MiataMike/FE04-Dash/Teensy Code/Dash Plans.jpg

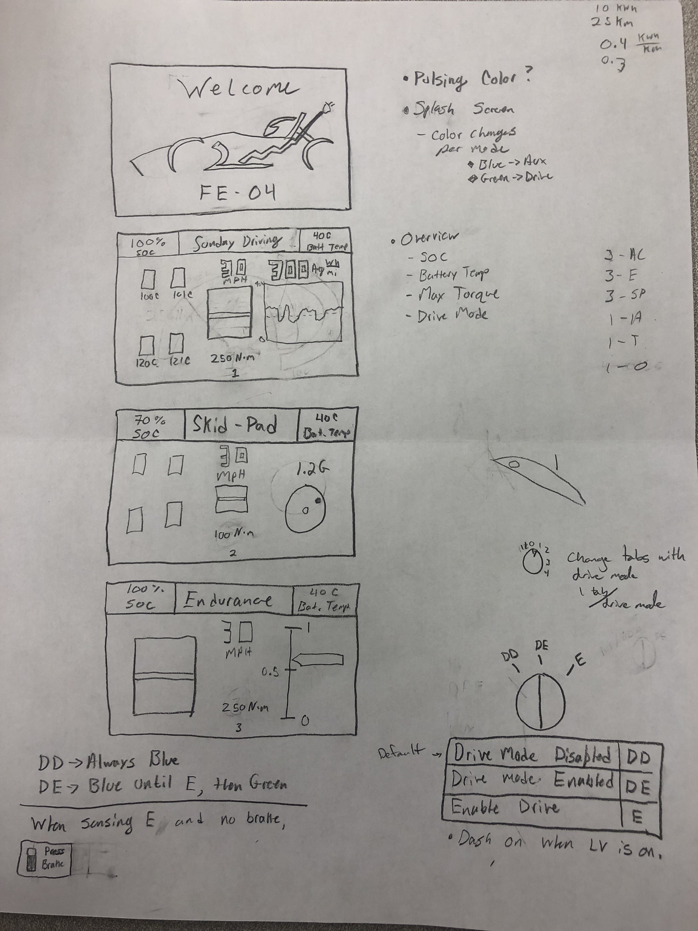
Teensy Code/Dash Plans.jpg
