MiataMike/FE04-Dash/Teensy Code/rnd.bmp

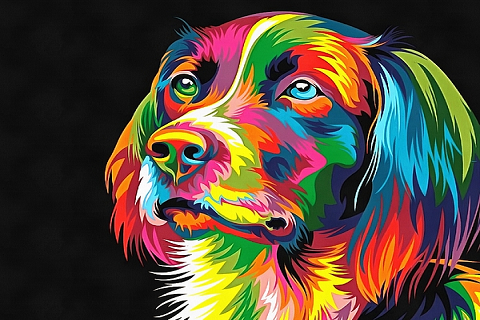
Teensy Code/rnd.bmp
