MiataMike/FE04-Dash/Teensy Code/Teensy code compliation.pptx

## Teensy code compliation

## Installing teensyduino on computer

https://www.pjrc.com/teensy/teensyduino.html

## Installing libraries

Install all of these from sketch->include library-> manage libraries

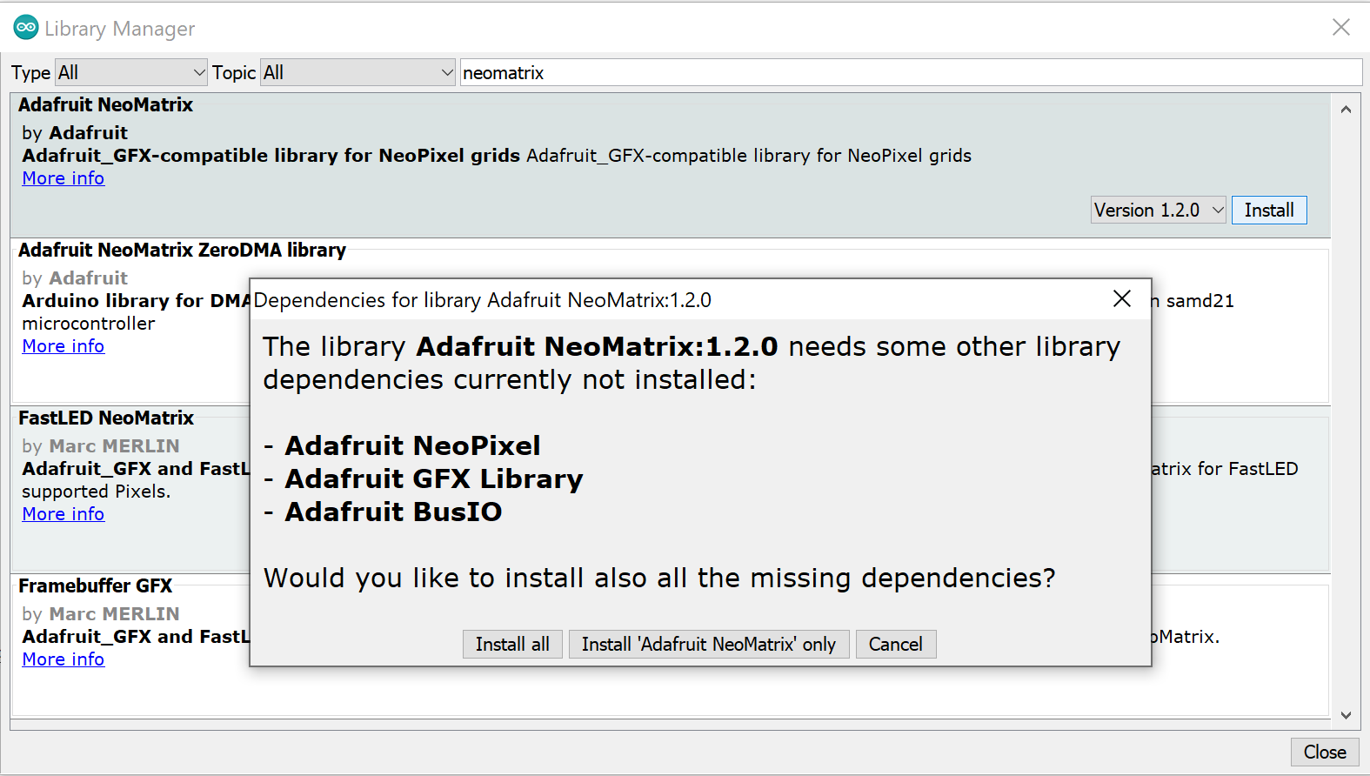
[picture p3: figure]

## Add t3 libraries

These .zip files are included in the root directory
FlexCAN_t3.zip
HX8357_t3.zip

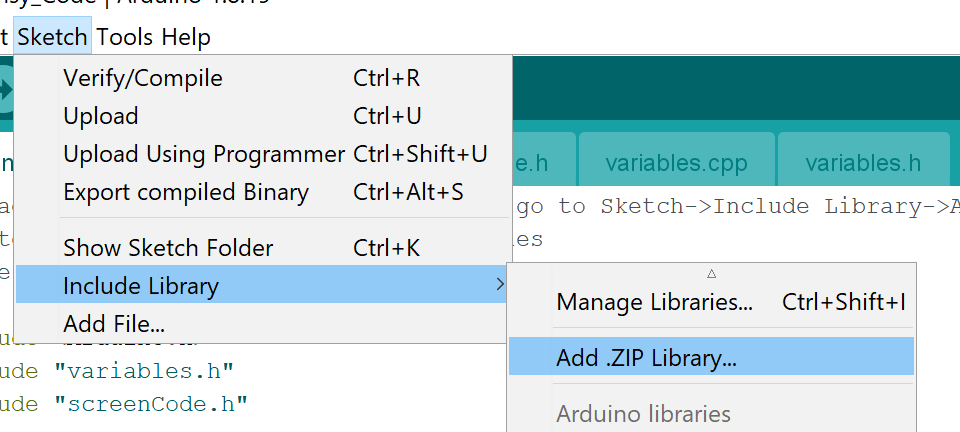
[picture p4: figure]
