MiataMike/FE04-Dash/Center Dash/Dash Sticker.pdf

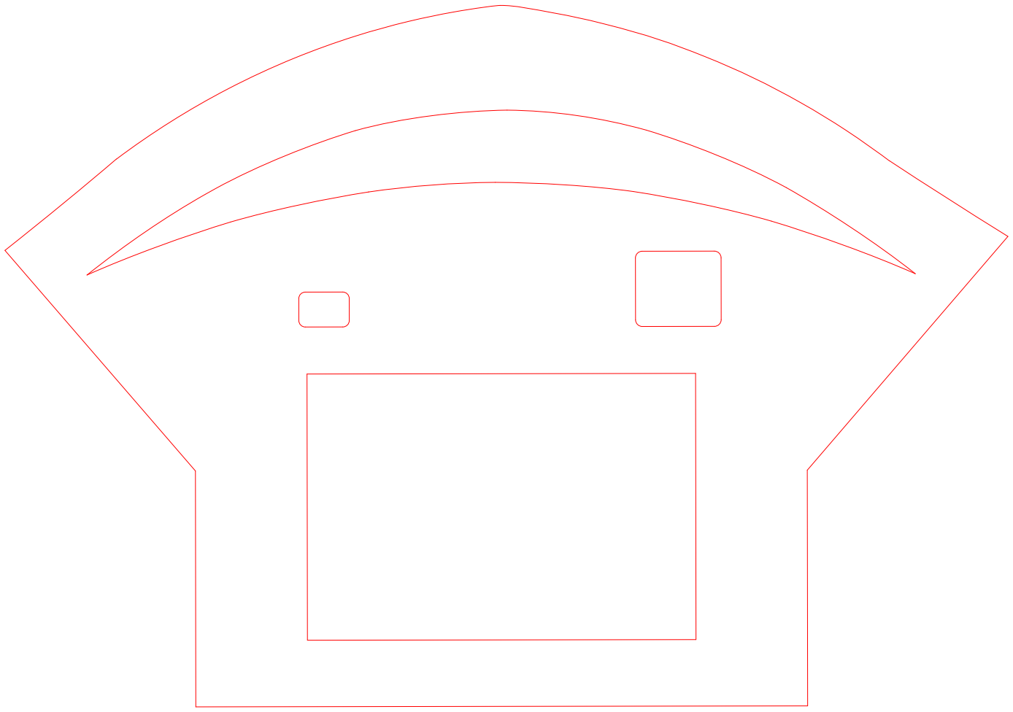
[picture p5: figure]
