MiataMike/FE04-Dash/Teensy Code/mroom.bmp

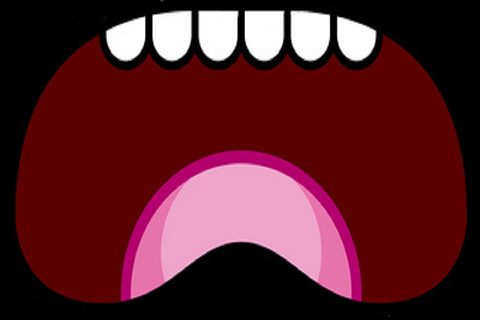
Teensy Code/mroom.bmp
