MiataMike/FE04-Dash/Steering Wheel/3D Printed Enclosure and Parts/wheel assembly v2.SLDASM

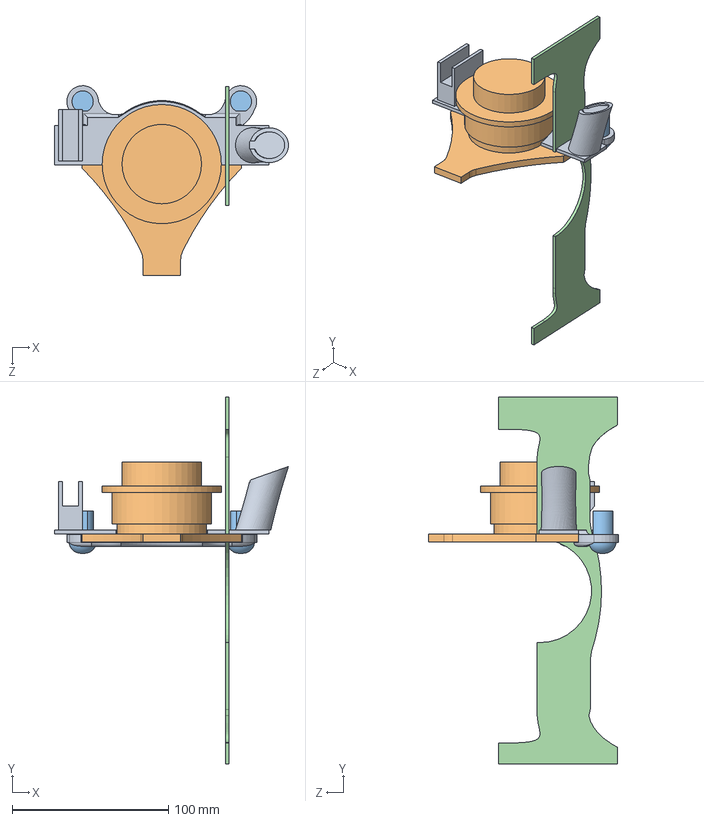
[picture p7: CAD file, 2018-05-23]
Steering Wheel/3D Printed Enclosure and Parts/wheel assembly v2.SLDASM
149.6 x 234.6 x 121.2 mm
Paddle Enclosure V3
steering_wheel
button x 2
Paddles
