MiataMike/FE04-Dash/Left Ear/Left Ear Master v2.SLDPRT

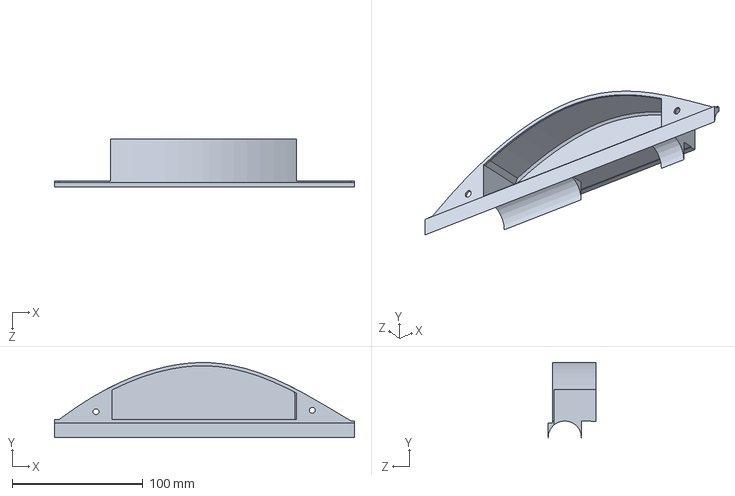
[picture p8: CAD file, 2018-03-25]
Left Ear/Left Ear Master v2.SLDPRT
229.4 x 57.4 x 36.4 mm
