MiataMike/FE04-Dash/Right Ear/Right Ear (BEST).SLDPRT

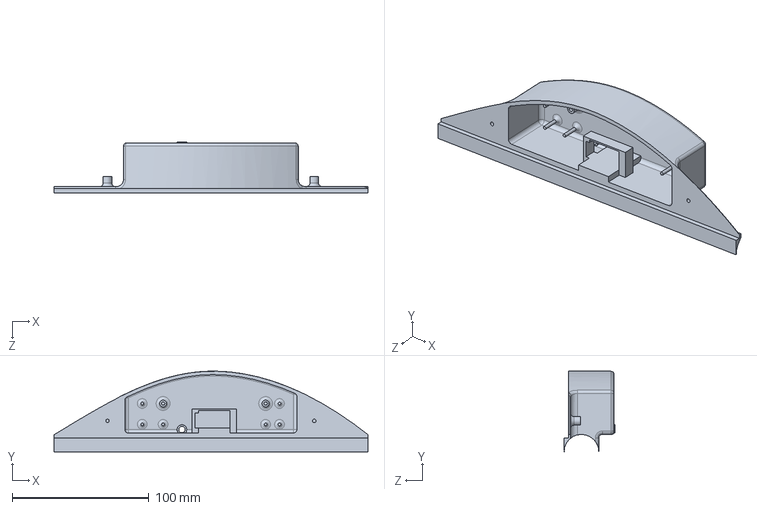
[picture p9: CAD file, 2018-03-25]
Right Ear/Right Ear (BEST).SLDPRT
229.6 x 58.9 x 37.2 mm
