MiataMike/FE04-Dash/Steering Wheel/3D Printed Enclosure and Parts/Right Ear Needle Holder.SLDPRT

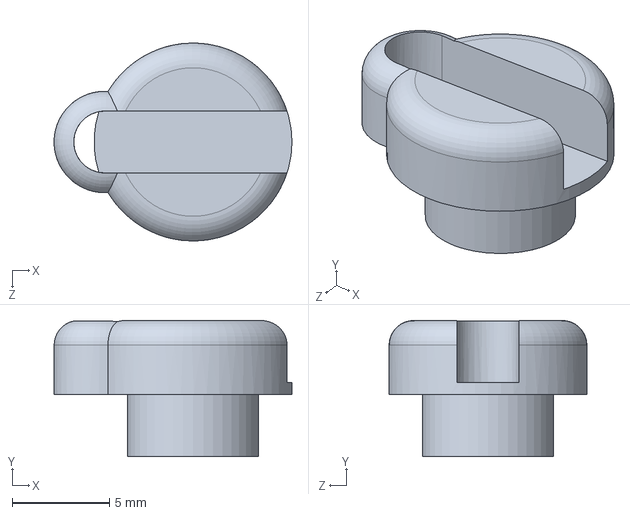
[picture p10: CAD file, 2018-05-23]
Steering Wheel/3D Printed Enclosure and Parts/Right Ear Needle Holder.SLDPRT
12.2 x 6.98 x 10.2 mm
