MiataMike/FE04-Dash/Right Ear/Servo Needle.SLDPRT

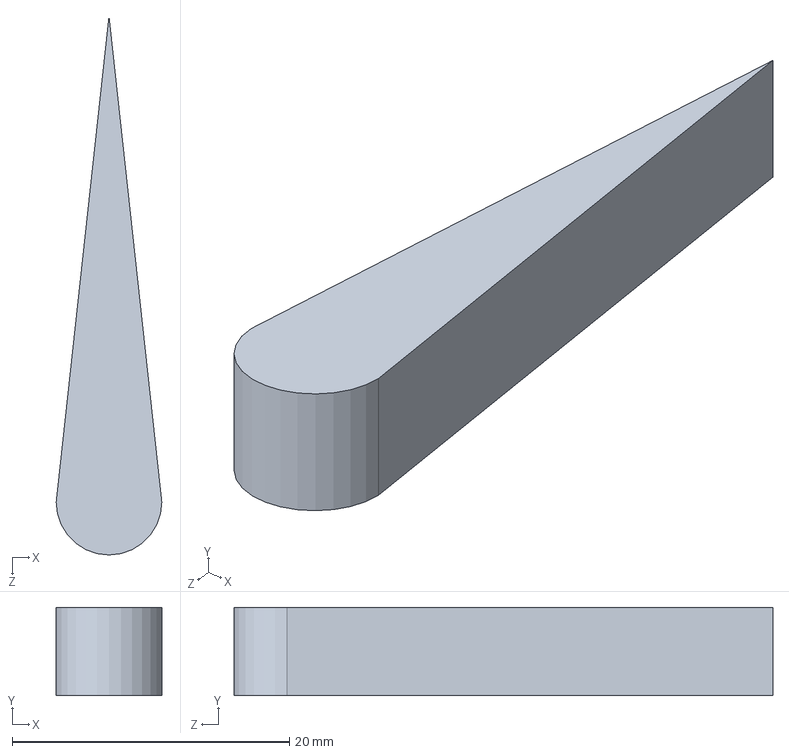
[picture p11: CAD file, 2018-03-24]
Right Ear/Servo Needle.SLDPRT
7.62 x 6.35 x 38.9 mm
