MiataMike/FE04-Dash/Steering Wheel/3D Printed Enclosure and Parts/Paddles_SM.DXF

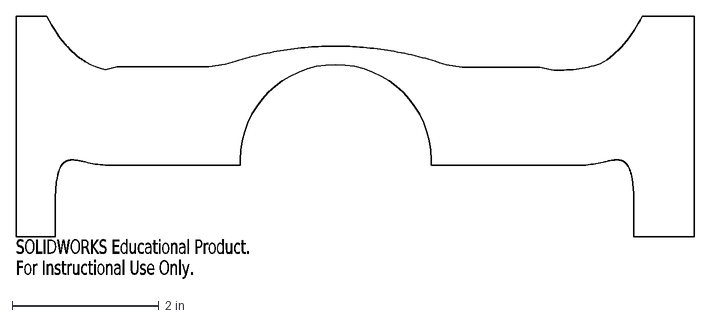
[picture p12: CAD file, 2018-05-23]
Steering Wheel/3D Printed Enclosure and Parts/Paddles_SM.DXF
SOLIDWORKS Educational Product.
For Instructional Use Only.
