MiataMike/FE04-Dash/Steering Wheel/3D Printed Enclosure and Parts/Paddles.SLDPRT

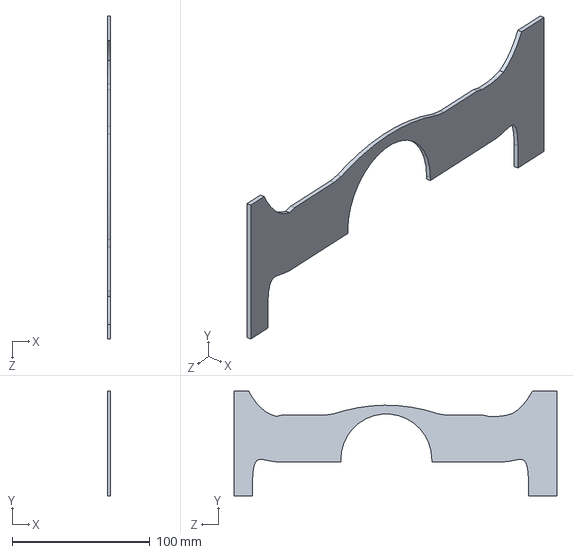
[picture p13: CAD file, 2018-05-23]
Steering Wheel/3D Printed Enclosure and Parts/Paddles.SLDPRT
2.38 x 76.2 x 234.6 mm
