MiataMike/FE04-Dash/Steering Wheel/3D Printed Enclosure and Parts/Needle.SLDPRT

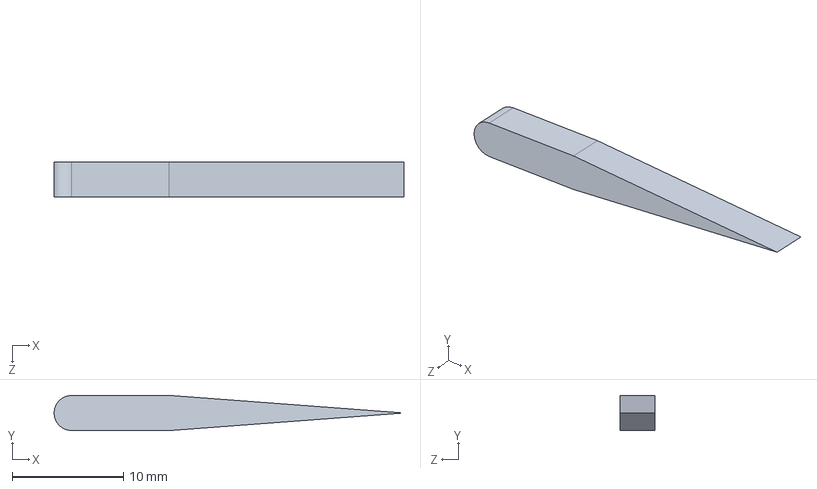
[picture p14: CAD file, 2018-05-23]
Steering Wheel/3D Printed Enclosure and Parts/Needle.SLDPRT
31.5 x 3.17 x 3.17 mm
