MiataMike/FE04-Dash/Steering Wheel/3D Printed Enclosure and Parts/Paddle Enclosure V4.SLDPRT

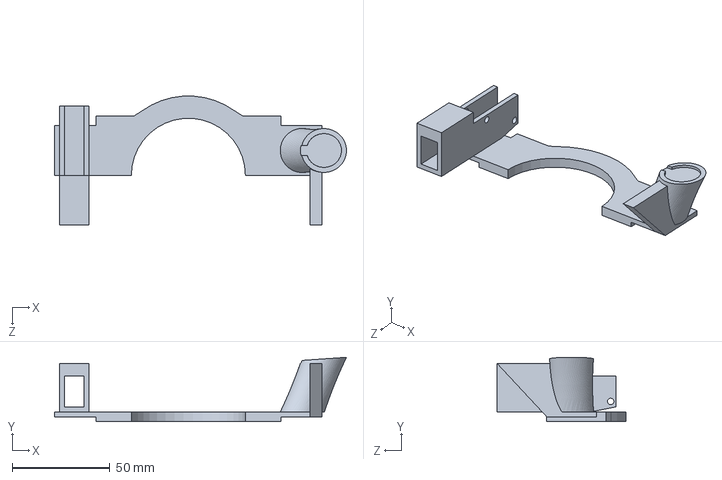
[picture p15: CAD file, 2018-05-23]
Steering Wheel/3D Printed Enclosure and Parts/Paddle Enclosure V4.SLDPRT
149.6 x 33.0 x 65.9 mm
