MiataMike/FE04-Dash/Steering Wheel/3D Printed Enclosure and Parts/Knob.SLDPRT

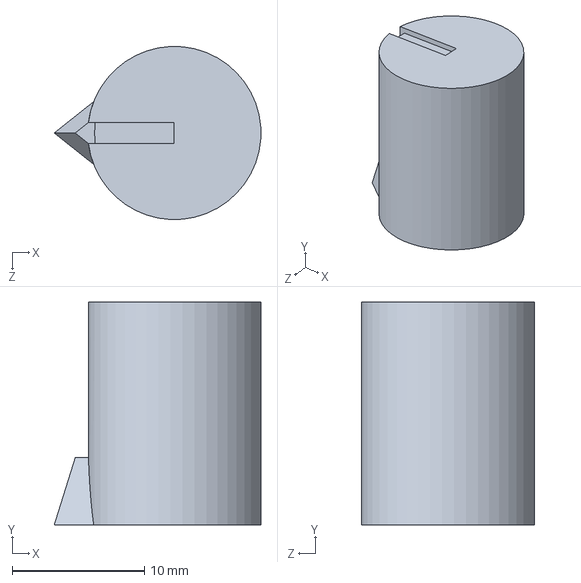
[picture p16: CAD file, 2018-05-23]
Steering Wheel/3D Printed Enclosure and Parts/Knob.SLDPRT
15.6 x 16.8 x 13.1 mm
