MiataMike/FE04-Dash/Steering Wheel/3D Printed Enclosure and Parts/Paddle Enclosure.SLDPRT

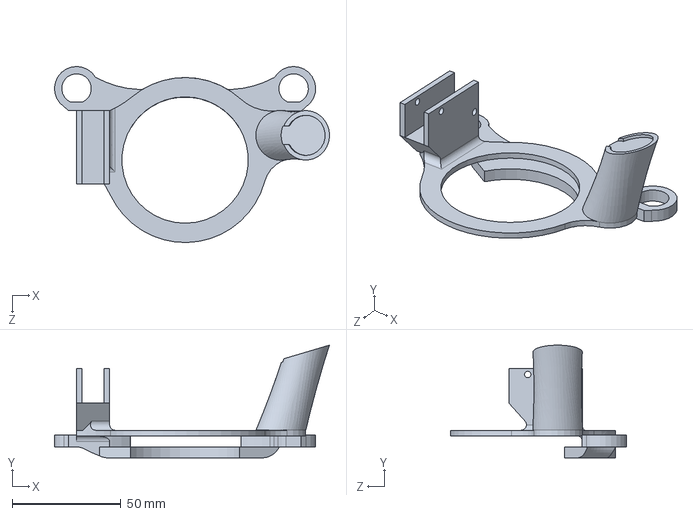
[picture p17: CAD file, 2018-05-23]
Steering Wheel/3D Printed Enclosure and Parts/Paddle Enclosure.SLDPRT
126.6 x 51.9 x 81.0 mm
