MiataMike/FE04-Dash/Steering Wheel/3D Printed Enclosure and Parts/steering_wheel.SLDPRT

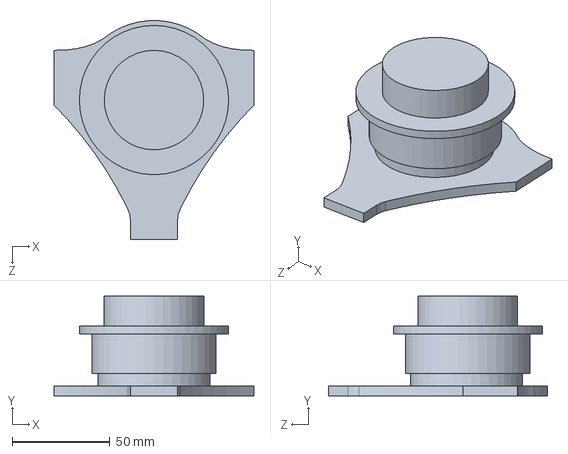
[picture p18: CAD file, 2018-05-23]
Steering Wheel/3D Printed Enclosure and Parts/steering_wheel.SLDPRT
102.1 x 51.1 x 111.7 mm
