MiataMike/FE04-Dash/Steering Wheel/3D Printed Enclosure and Parts/Switch.SLDPRT

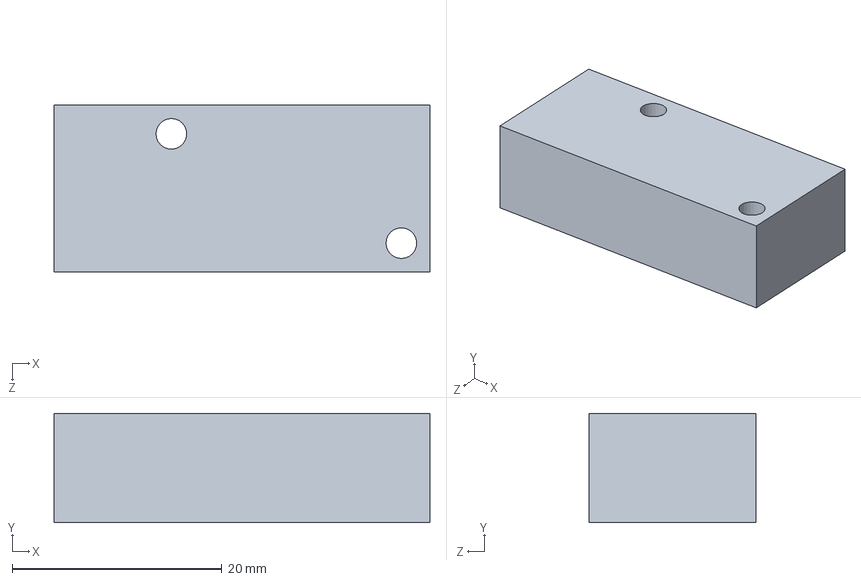
[picture p19: CAD file, 2018-04-06]
Steering Wheel/3D Printed Enclosure and Parts/Switch.SLDPRT
35.8 x 10.4 x 15.9 mm
