MiataMike/FE04-Dash/Steering Wheel/3D Printed Enclosure and Parts/button.SLDPRT

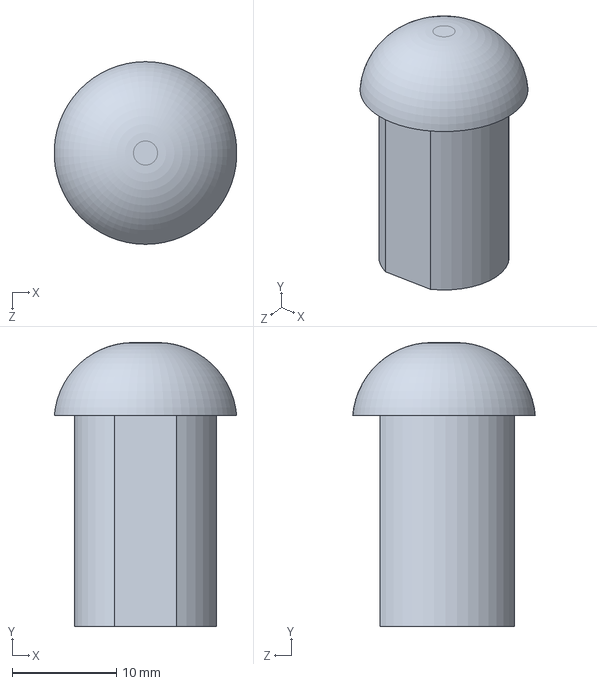
[picture p20: CAD file, 2018-04-06]
Steering Wheel/3D Printed Enclosure and Parts/button.SLDPRT
17.5 x 27.2 x 17.5 mm
