MiataMike/FE04-Dash/Steering Wheel/3D Printed Enclosure and Parts/wheel assembly.SLDASM

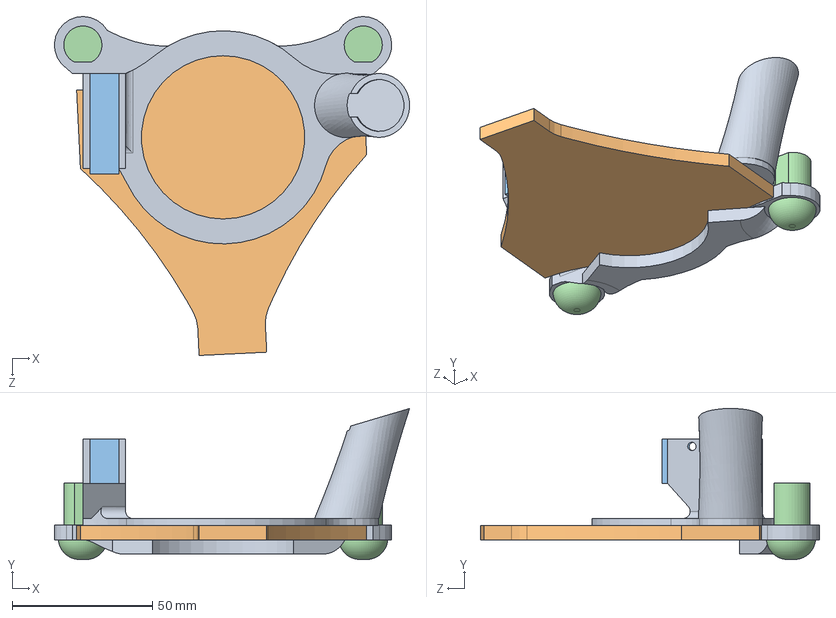
[picture p21: CAD file, 2018-04-06, an earlier design]
Steering Wheel/3D Printed Enclosure and Parts/wheel assembly.SLDASM
126.6 x 53.8 x 120.8 mm
Paddle Enclosure
steering_wheel
Switch
button x 2
