MiataMike/FE04-Dash/Steering Wheel/3D Printed Enclosure and Parts/Paddle Enclosure V3.SLDPRT

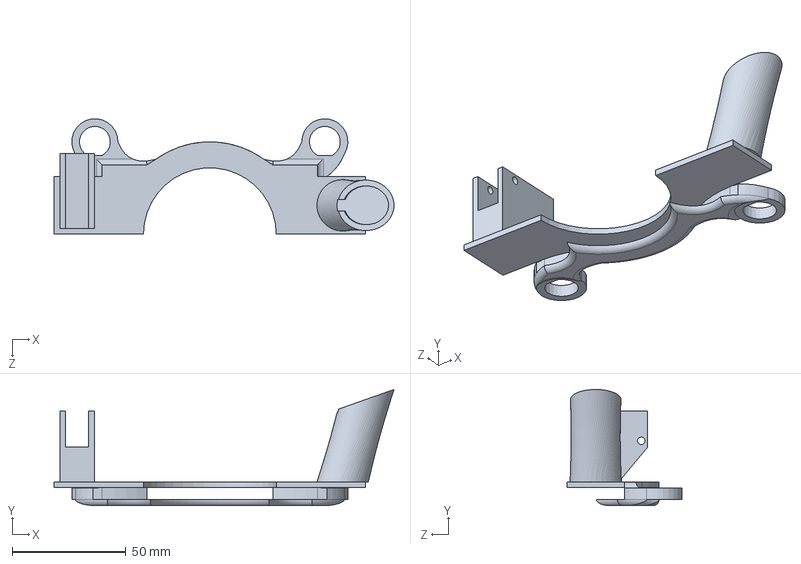
[picture p22: CAD file, 2018-05-23, an earlier design]
Steering Wheel/3D Printed Enclosure and Parts/Paddle Enclosure V3.SLDPRT
149.6 x 51.1 x 50.8 mm
