MiataMike/FE04-Dash/(list of files, cad)

Other CAD files:
Steering Wheel/3D Printed Enclosure and Parts/Right Ear Needle.SLDPRT
Steering Wheel/3D Printed Enclosure and Parts/Paddle Enclosure V2.SLDPRT
Left Ear/Left Ear Master v2.STL
Right Ear/Right Ear (BEST).STL
Right Ear/Servo Needle.DXF
Steering Wheel/3D Printed Enclosure and Parts/Knob.STL
Steering Wheel/3D Printed Enclosure and Parts/Paddle Enclosure V3.STL
Steering Wheel/3D Printed Enclosure and Parts/Paddle Enclosure V4.STL
Steering Wheel/3D Printed Enclosure and Parts/Right Ear Needle Holder.STL
