MiataMike/FE04-Dash/Center Dash/Center Dash.brd

## EAGLE design Center Dash/Center Dash.brd (2021-10-16)

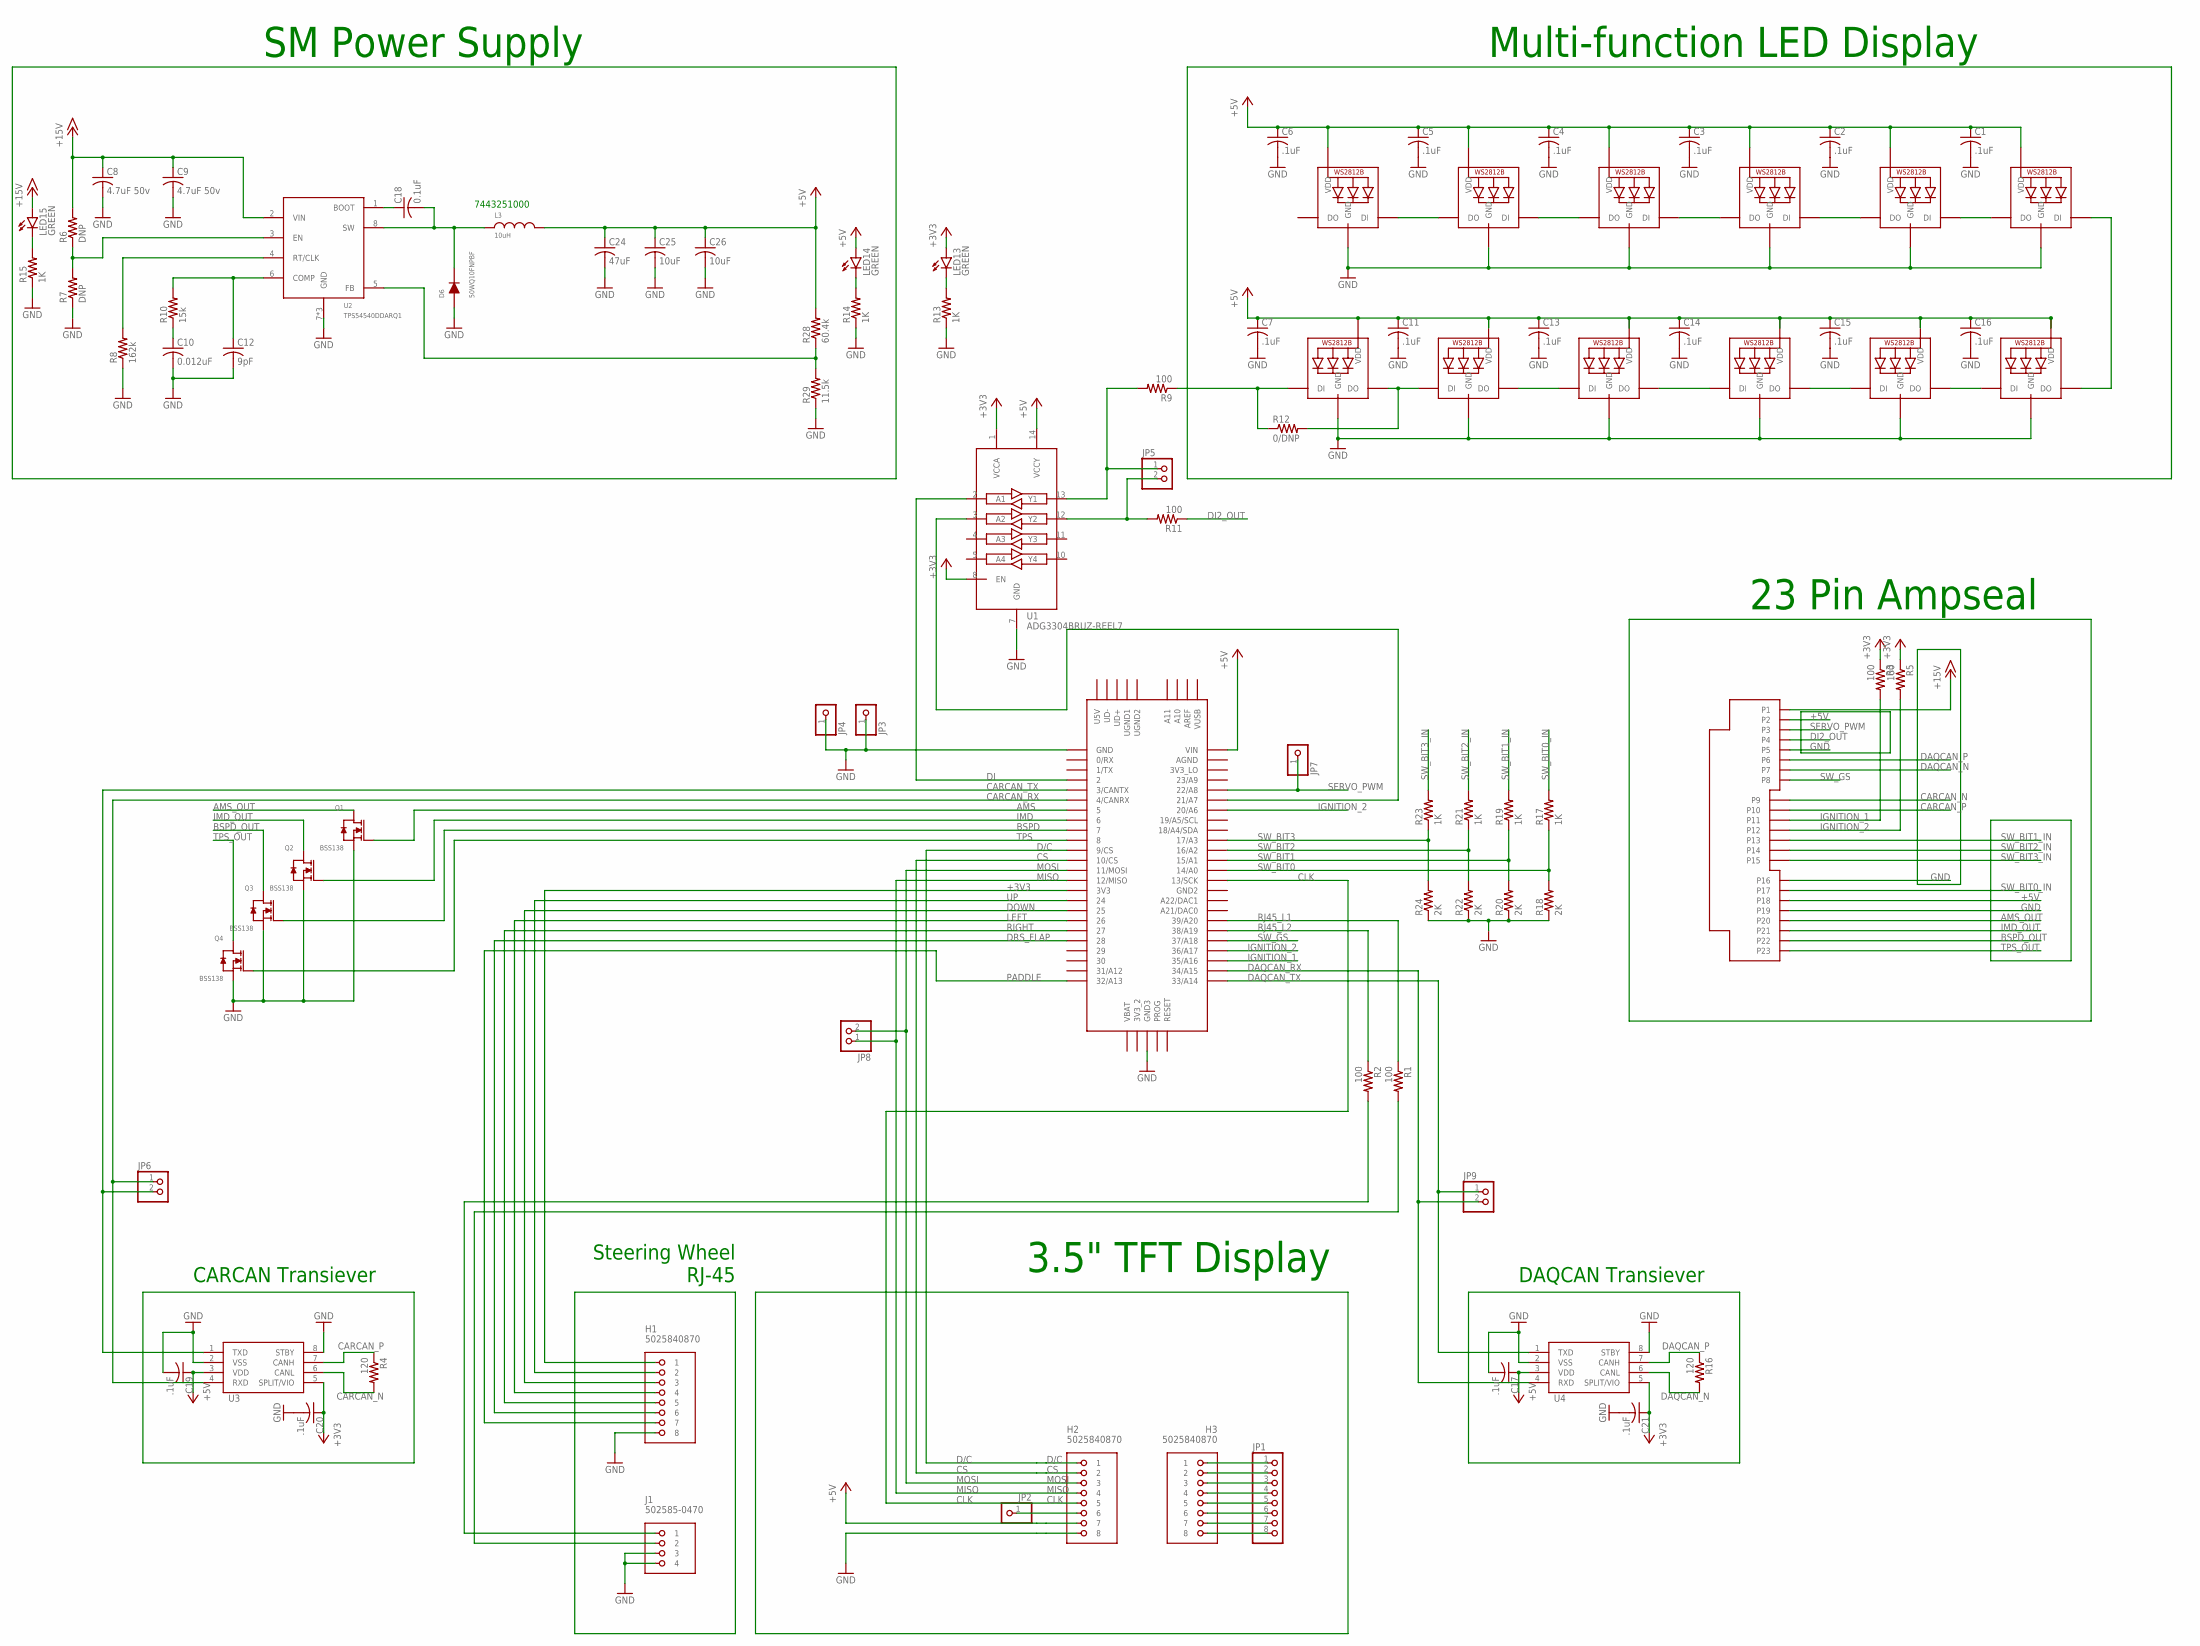
[picture p23: schematic Center Dash.sch]

Parts:
C1, C2, C3, C4, C5, C6, C7, C11, C13, C14, C15, C16: .1uF; C0603K; PARTNO GRM188R61A106KE69D
C8, C9: 4.7uF 50v; C1206; PARTNO GRM31CR71H475KA12L
C10: 0.012uF; C0603K; PARTNO GRM188R71H123KA01D
C12: 9pF; C0603K; PARTNO GRM1885C1H9R0DA01D
C17, C19, C20, C21: .1uF; C0805
C18: 0.1uF; C0603K; PARTNO GRM188R71E104KA01D
C24: 47uF; C1206; PARTNO GRM31CR61A476ME15L
C25, C26: 10uF; C0603K; PARTNO GRM188R61A106KE69D
D6: 50WQ10FNPBF; DPAK; PARTNO VS-50WQ10FNPBF
H1, H2, H3: 5025840870; MOLEX-CLIKMATE-8-VERTICAL-HEADER
J1: 502585-0470; MOLEX-CLIKMATE-4-R/A
JP1: PINHD-1X8; 1X08
JP2, JP3, JP4, JP7: PINHD-1X1; 1X01
JP5, JP6, JP8, JP9: PINHD-1X2; 1X02
L3: 10uH; WURTH-744325XXXX; PARTNO 7443251000
LED1, LED2, LED3, LED4, LED5, LED6, LED7, LED8, LED9, LED10, LED11, LED12: WS2812B5050; WS2812B
LED13, LED14, LED15: GREEN; CHIP-LED0805; PARTNO 598-8170-107F
Q1, Q2, Q3, Q4: BSS138
R1, R2, R3, R5, R9, R11: 100; R0805
R4, R16: 120; R0805
R6, R7: DNP; R0603; PARTNO *
R8: 162k; R0603; PARTNO ERJ-3EKF1623V
R10: 15k; R0603; PARTNO ERJ-3EKF1502V
R12: 0/DNP; R0805
R13, R14, R15, R17, R19, R21, R23: 1K; R0805; PARTNO ERJ-6ENF1001V
R18, R20, R22, R24: 2K; R0805; PARTNO ERJ-6ENF1001V
R28: 60.4k; R0603; PARTNO ERJ-3EKF6042V
R29: 11.5k; R0603; PARTNO ERJ-3EKF1152V
U1: ADG3304BRUZ-REEL7; ADG3304
U2: TPS54540DDARQ1; TPS54540; PARTNO TPS54540DDAR
U3, U4: MCP256X-SOIC; SOIC8-N_MC
U$1: TE-776200-1
U$2: TEENSY_3.5/3.6

Connections:
5VREG_EN: R6.1, R7.2, U2.3 (EN)
+3V3: C20.1, C21.1, H1.1, LED13.A, R3.1, R5.1, U1.1 (VCCA), U1.8 (EN), U3.5 (SPLIT/VIO), U4.5 (SPLIT/VIO), U$2.3V3
+5V: C1.1, C2.1, C3.1, C4.1, C5.1, C6.1, C7.1, C11.1, C13.1, C14.1, C15.1, C16.1, C17.1, C19.1, C24.1, C25.1, C26.1, H2.7, L3.P$2, LED1.1-VDD (VDD), LED2.1-VDD (VDD), LED3.1-VDD (VDD), LED4.1-VDD (VDD), LED5.1-VDD (VDD), LED6.1-VDD (VDD), LED7.1-VDD (VDD), LED8.1-VDD (VDD), LED9.1-VDD (VDD), LED10.1-VDD (VDD), LED11.1-VDD (VDD), LED12.1-VDD (VDD), LED14.A, R28.2, U1.14 (VCCY), U3.3 (VDD), U4.3 (VDD), U$1.P$2 (P2), U$1.P$18 (P18), U$2.VIN
+15V: C8.1, C9.1, LED15.A, R6.2, U2.2 (VIN), U$1.P$1 (P1)
AMS: Q1.G, U$2.5
AMS_OUT: Q1.D, U$1.P$20 (P20)
BOOT_5V: C18.1, U2.1 (BOOT)
BSPD: Q3.G, U$2.7
BSPD_OUT: Q3.D, U$1.P$22 (P22)
CARCAN_N: R4.2, U3.6 (CANL), U$1.P$9 (P9)
CARCAN_P: R4.1, U3.7 (CANH), U$1.P$10 (P10)
CARCAN_RX: JP6.1, U3.4 (RXD), U$2.4/CANRX
CARCAN_TX: JP6.2, U3.1 (TXD), U$2.3/CANTX
CLK: H2.5, U$2.13/SCK
COMP_5V: C12.1, R10.2, U2.6 (COMP)
CS: H2.2, U$2.10/CS
D/C: H2.1, U$2.9/CS
DAQCAN_N: R16.2, U4.6 (CANL), U$1.P$7 (P7)
DAQCAN_P: R16.1, U4.7 (CANH), U$1.P$6 (P6)
DAQCAN_RX: JP9.2, U4.4 (RXD), U$2.34/A15
DAQCAN_TX: JP9.1, U4.1 (TXD), U$2.33/A14
DI: U1.2 (A1), U$2.2
DI2_MORE: JP5.2, R11.2, U1.12 (Y2)
DI2_OUT: R11.1, U$1.P$4 (P4)
DI_MORE: U1.3 (A2), U$2.21/A7
DOWN: H1.3, U$2.25
DRS_FLAP: H1.6, U$2.28
FB_5V: R28.1, R29.2, U2.5 (FB)
GND: C1.2, C2.2, C3.2, C4.2, C5.2, C6.2, C7.2, C8.2, C9.2, C10.2, C11.2, C12.2, C13.2, C14.2, C15.2, C16.2, C17.2, C19.2, C20.2, C21.2, C24.2, C25.2, C26.2, D6.1 (ANODE), D6.3 (ANODE), H1.8, H2.8, J1.3, J1.4, JP3.1, JP4.1, LED1.3-GND (GND), LED2.3-GND (GND), LED3.3-GND (GND), LED4.3-GND (GND), LED5.3-GND (GND), LED6.3-GND (GND), LED7.3-GND (GND), LED8.3-GND (GND), LED9.3-GND (GND), LED10.3-GND (GND), LED11.3-GND (GND), LED12.3-GND (GND), Q1.S, Q2.S, Q3.S, Q4.S, R7.1, R8.1, R13.1, R14.1, R15.1, R18.1, R20.1, R22.1, R24.1, R29.1, U1.7 (GND), U2.7 (GND), U2.PAD (GND), U2.PAD1 (GND), U3.2 (VSS), U3.8 (STBY), U4.2 (VSS), U4.8 (STBY), U$1.P$5 (P5), U$1.P$16 (P16), U$1.P$19 (P19), U$2.GND, U$2.GND3
IGNITION_1: R3.2, U$1.P$11 (P11), U$2.35/A16
IGNITION_2: R5.2, U$1.P$12 (P12), U$2.20/A6, U$2.36/A17
IMD: Q2.G, U$2.6
IMD_OUT: Q2.D, U$1.P$21 (P21)
LEFT: H1.4, U$2.26
MISO: H2.4, JP8.1, U$2.12/MISO
MOSI: H2.3, JP8.2, U$2.11/MOSI
unnamed: LED1.2-DOUT (DO), LED2.4-DIN (DI), R12.2
unnamed: H3.1, JP1.1
unnamed: LED2.2-DOUT (DO), LED3.4-DIN (DI)
unnamed: LED3.2-DOUT (DO), LED4.4-DIN (DI)
unnamed: LED4.2-DOUT (DO), LED5.4-DIN (DI)
unnamed: LED5.2-DOUT (DO), LED6.4-DIN (DI)
unnamed: LED6.2-DOUT (DO), LED7.4-DIN (DI)
unnamed: LED1.4-DIN (DI), R9.1, R12.1
unnamed: H3.2, JP1.2
unnamed: H3.3, JP1.3
unnamed: H3.4, JP1.4
unnamed: H3.5, JP1.5
unnamed: H3.6, JP1.6
unnamed: H3.7, JP1.7
unnamed: LED14.C, R14.2
unnamed: JP5.1, R9.2, U1.13 (Y1)
unnamed: LED15.C, R15.2
unnamed: H3.8, JP1.8
unnamed: H2.6, JP2.1
unnamed: C10.1, R10.1
unnamed: J1.1, R2.2
unnamed: J1.2, R1.2
unnamed: LED7.2-DOUT (DO), LED8.4-DIN (DI)
unnamed: LED8.2-DOUT (DO), LED9.4-DIN (DI)
unnamed: LED9.2-DOUT (DO), LED10.4-DIN (DI)
unnamed: LED10.2-DOUT (DO), LED11.4-DIN (DI)
unnamed: LED11.2-DOUT (DO), LED12.4-DIN (DI)
unnamed: LED13.C, R13.2
PADDLE: H1.7, U$2.32/A13
RIGHT: H1.5, U$2.27
RJ45_L1: R1.1, U$2.39/A20
RJ45_L2: R2.1, U$2.38/A19
RT_5V: R8.2, U2.4 (RT/CLK)
SERVO_PWM: JP7.1, U$1.P$3 (P3), U$2.22/A8
SW_5V: C18.2, D6.2 (CATHODE), L3.P$1, U2.8 (SW)
SW_BIT0: R17.1, R18.2, U$2.14/A0
SW_BIT0_IN: R17.2, U$1.P$17 (P17)
SW_BIT1: R19.1, R20.2, U$2.15/A1
SW_BIT1_IN: R19.2, U$1.P$13 (P13)
SW_BIT2: R21.1, R22.2, U$2.16/A2
SW_BIT2_IN: R21.2, U$1.P$14 (P14)
SW_BIT3: R23.1, R24.2, U$2.17/A3
SW_BIT3_IN: R23.2, U$1.P$15 (P15)
SW_GS: U$1.P$8 (P8), U$2.37/A18
TPS: Q4.G, U$2.8
TPS_OUT: Q4.D, U$1.P$23 (P23)
UP: H1.2, U$2.24

Notes on the sheet:
7443251000
Steering Wheel RJ-45
Multi-function LED Display
3.5" TFT Display
23 Pin Ampseal
SM Power Supply
CARCAN Transiever
DAQCAN Transiever

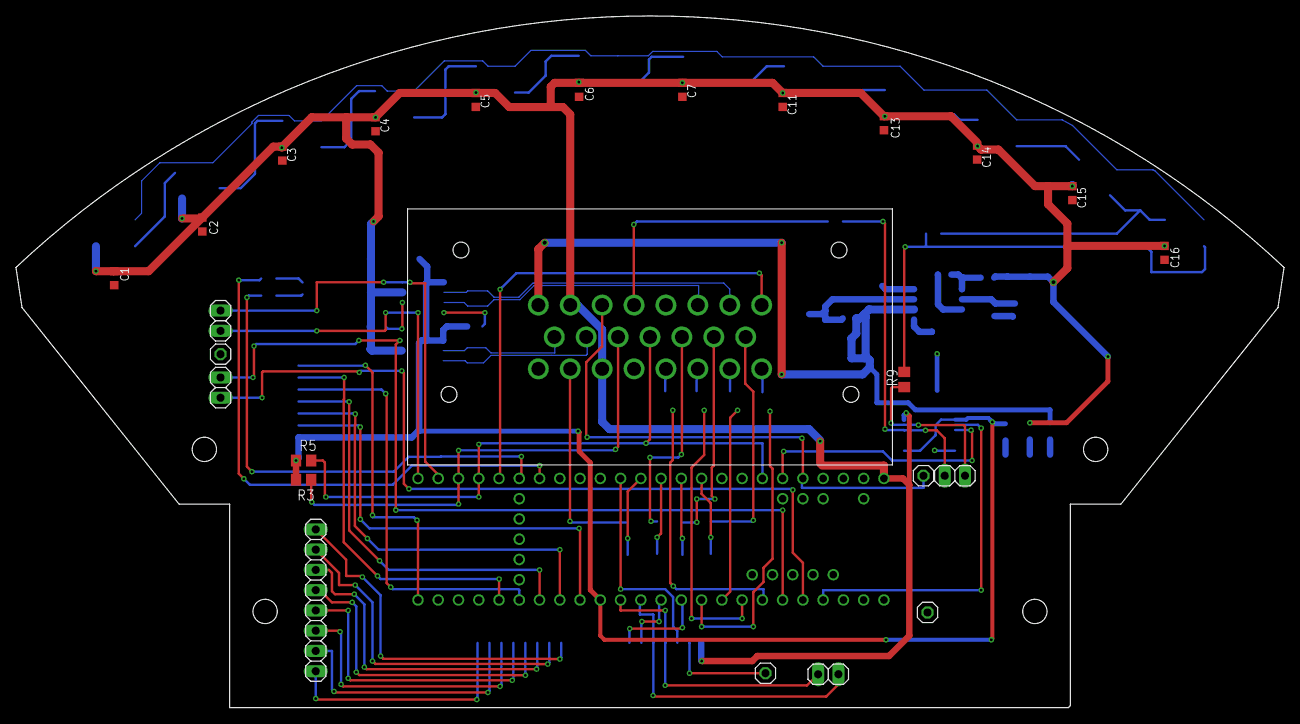
[picture p24: board Center Dash.brd from above]

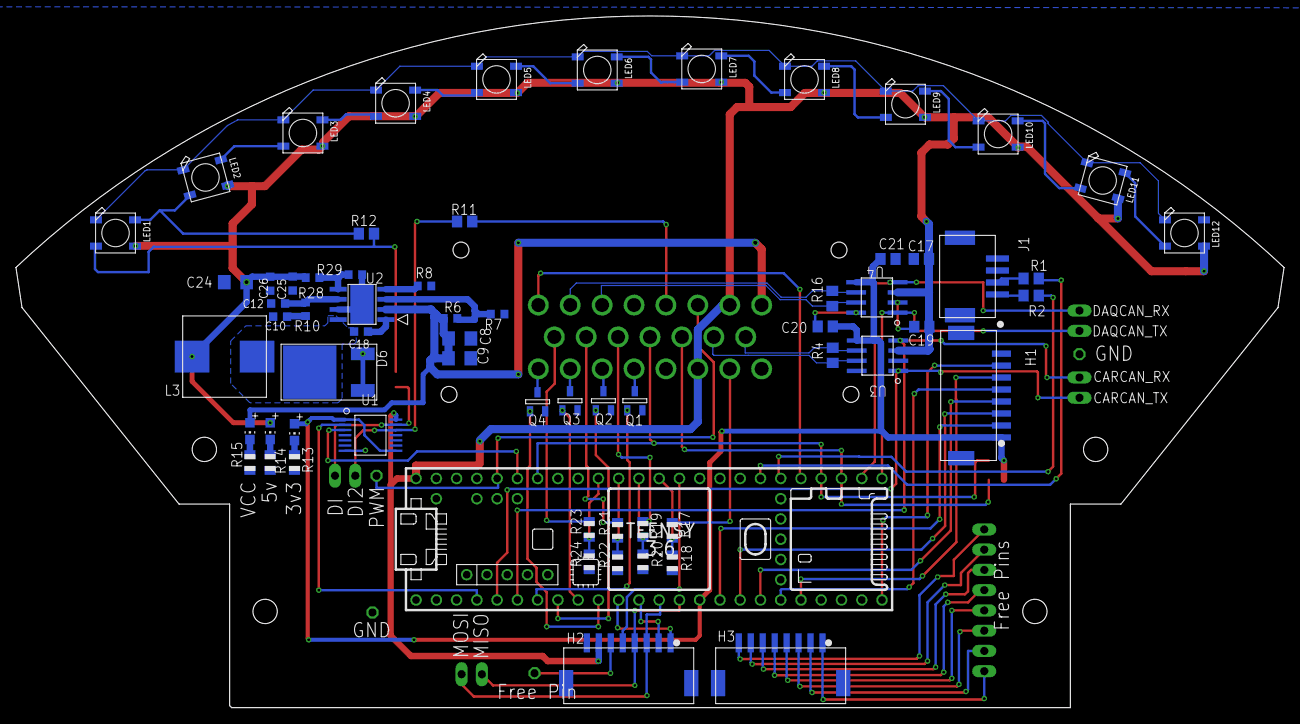
[picture p25: board Center Dash.brd from below]

Board: 2 copper layers, 159.0 x 86.7 mm, 90 parts (65 on the bottom side), 83 nets.
