MiataMike/FE04-Dash/Steering Wheel/Steering Wheel Board.brd

## EAGLE design Steering Wheel/Steering Wheel Board.brd (2018-04-06)

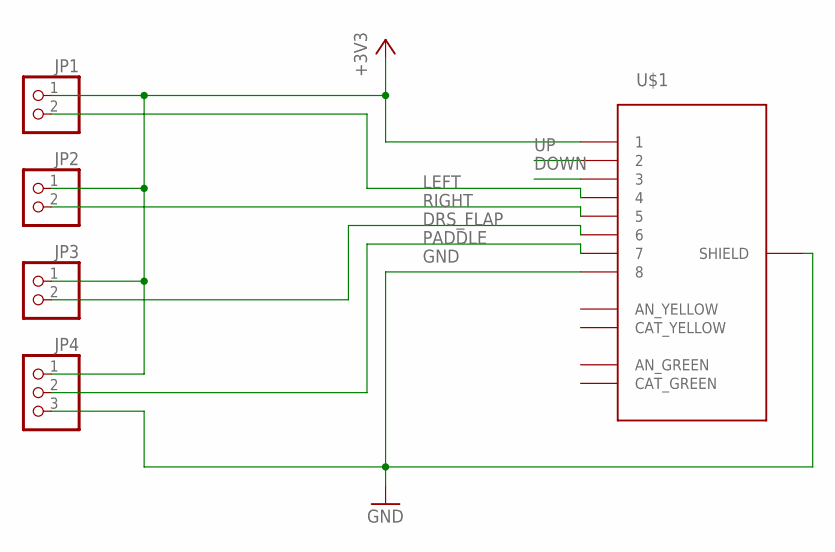
[picture p26: schematic Steering Wheel Board.sch]

Parts:
JP1, JP2, JP3: PINHD-1X2; 1X02
JP4: PINHD-1X3; 1X03
U$1: RJ-45_12-PIN; RJ-45

Connections:
+3V3: JP1.1, JP2.1, JP3.1, JP4.1, U$1.P$1 (1)
DOWN: U$1.P$3 (3)
DRS_FLAP: JP3.2, U$1.P$6 (6)
GND: JP4.3, U$1.P$8 (8), U$1.P$13 (SHIELD)
LEFT: JP1.2, U$1.P$4 (4)
PADDLE: JP4.2, U$1.P$7 (7)
RIGHT: JP2.2, U$1.P$5 (5)
UP: U$1.P$2 (2)

Board: 2 copper layers, 5 parts (0 on the bottom side), 6 nets, no tracks yet.
