MiataMike/FE04-Dash/Left Ear/Left Ear Board.brd

## EAGLE design Left Ear/Left Ear Board.brd (2018-03-08)

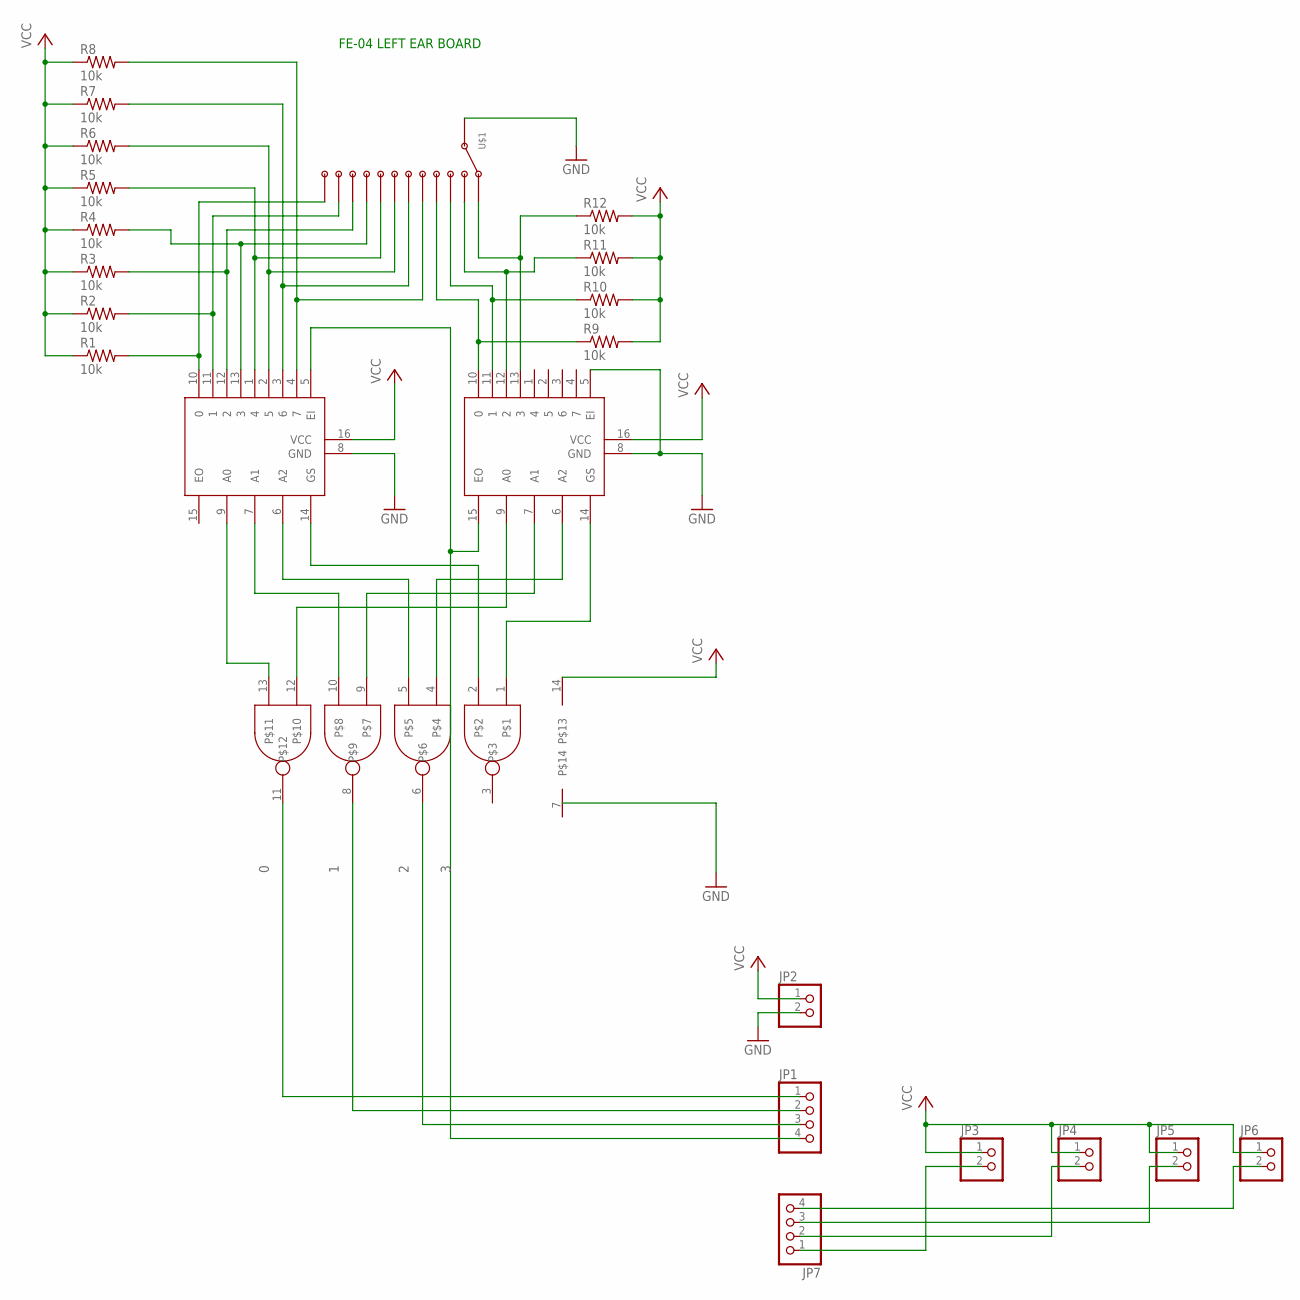
[picture p27: schematic Left Ear Board.sch]

Parts:
JP1, JP7: PINHD-1X4; 1X04
JP2, JP3, JP4, JP5, JP6: PINHD-1X2; 1X02
R1, R2, R3, R4, R5, R6, R7, R8, R9, R10, R11, R12: 10k; R0603; PARTNO ERJ-3EKF2201V
U$1: 12-POSITION-ROTARY; MC00L1NCQF
U$2, U$3: SN74LS148D; SOIC-16
U$4: QUAD_NAND; SOIC-14

Connections:
0: JP1.1, U$4.11
1: JP1.2, U$4.8
2: JP1.3, U$4.6
3: JP1.4, U$2.5 (EI), U$3.15 (EO)
GND: JP2.2, U$1.P$13 (WIPER), U$2.8 (GND), U$3.5 (EI), U$3.8 (GND)
unnamed: R1.2, U$1.P$12 (PIN12), U$2.10 (0)
unnamed: U$2.9 (A0), U$4.13
unnamed: U$3.9 (A0), U$4.12
unnamed: U$2.7 (A1), U$4.10
unnamed: U$3.7 (A1), U$4.9
unnamed: U$2.6 (A2), U$4.5
unnamed: U$3.6 (A2), U$4.4
unnamed: U$2.14 (GS), U$4.2
unnamed: U$3.14 (GS), U$4.1
unnamed: R9.1, U$1.P$4 (PIN4), U$3.10 (0)
unnamed: R10.1, U$1.P$3 (PIN3), U$3.11 (1)
unnamed: R11.1, U$1.P$2 (PIN2), U$3.12 (2)
unnamed: R12.1, U$1.P$1 (PIN1), U$3.13 (3)
unnamed: R2.2, U$1.P$11 (PIN11), U$2.11 (1)
unnamed: R3.2, U$1.P$10 (PIN10), U$2.12 (2)
unnamed: R4.2, U$1.P$9 (PIN9), U$2.13 (3)
unnamed: R5.2, U$1.P$8 (PIN8), U$2.1 (4)
unnamed: R6.2, U$1.P$7 (PIN7), U$2.2 (5)
unnamed: R7.2, U$1.P$6 (PIN6), U$2.3 (6)
unnamed: R8.2, U$1.P$5 (PIN5), U$2.4 (7)
unnamed: JP3.2, JP7.1
unnamed: JP4.2, JP7.2
unnamed: JP5.2, JP7.3
unnamed: JP6.2, JP7.4
VCC: JP2.1, JP3.1, JP4.1, JP5.1, JP6.1, R1.1, R2.1, R3.1, R4.1, R5.1, R6.1, R7.1, R8.1, R9.2, R10.2, R11.2, R12.2, U$2.16 (VCC), U$3.16 (VCC), U$4.14

Notes on the sheet:
FE-04 LEFT EAR BOARD

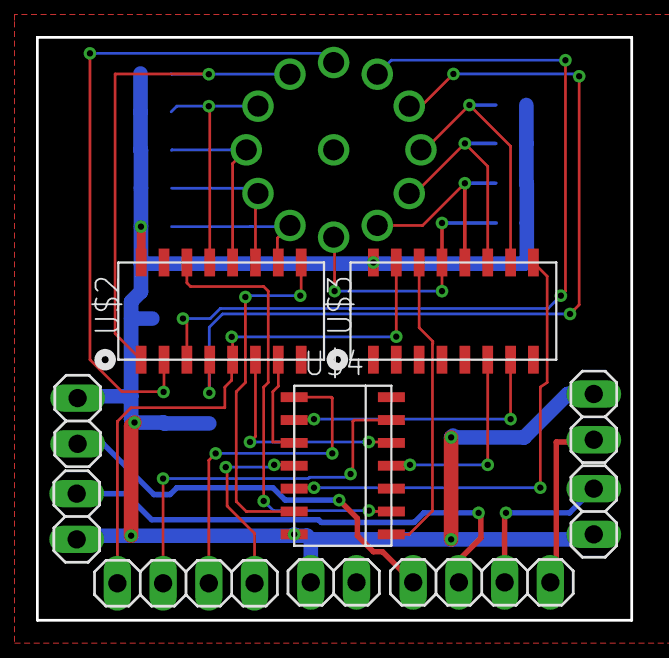
[picture p28: board Left Ear Board.brd from above]

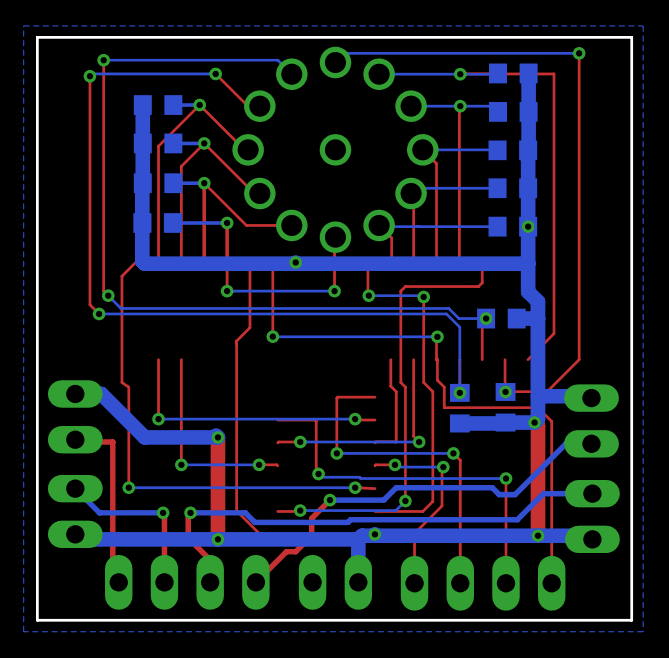
[picture p29: board Left Ear Board.brd from below]

Board: 2 copper layers, 33.0 x 32.4 mm, 23 parts (12 on the bottom side), 30 nets.
