MiataMike/FE04-Dash/Center Dash/RJ-45 Dash Daughter Board.brd

## EAGLE design Center Dash/RJ-45 Dash Daughter Board.brd (2018-02-11)

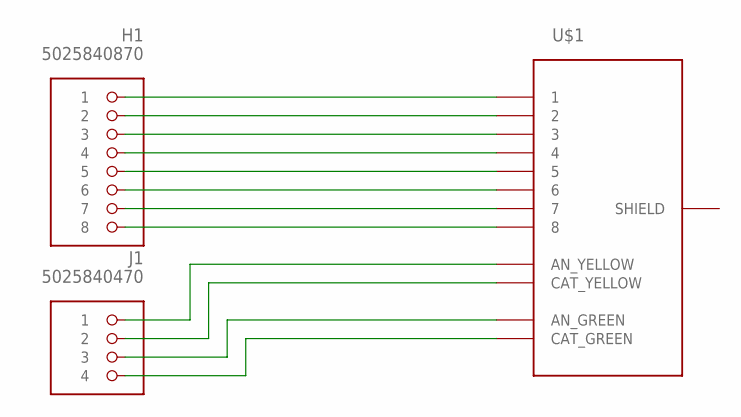
[picture p30: schematic RJ-45 Dash Daughter Board.sch]

Parts:
H1: 5025840870; MOLEX-CLIKMATE-8-VERTICAL-HEADER
J1: 5025840470; MOLEX-CLIKMATE-4-VERTICAL-HEADER
U$1: RJ-45_12-PIN; RJ-45

Connections:
unnamed: H1.1, U$1.P$1 (1)
unnamed: H1.2, U$1.P$2 (2)
unnamed: H1.3, U$1.P$3 (3)
unnamed: H1.4, U$1.P$4 (4)
unnamed: H1.5, U$1.P$5 (5)
unnamed: H1.6, U$1.P$6 (6)
unnamed: H1.7, U$1.P$7 (7)
unnamed: H1.8, U$1.P$8 (8)
unnamed: J1.1, U$1.P$9 (AN_YELLOW)
unnamed: J1.2, U$1.P$10 (CAT_YELLOW)
unnamed: J1.3, U$1.P$11 (AN_GREEN)
unnamed: J1.4, U$1.P$12 (CAT_GREEN)

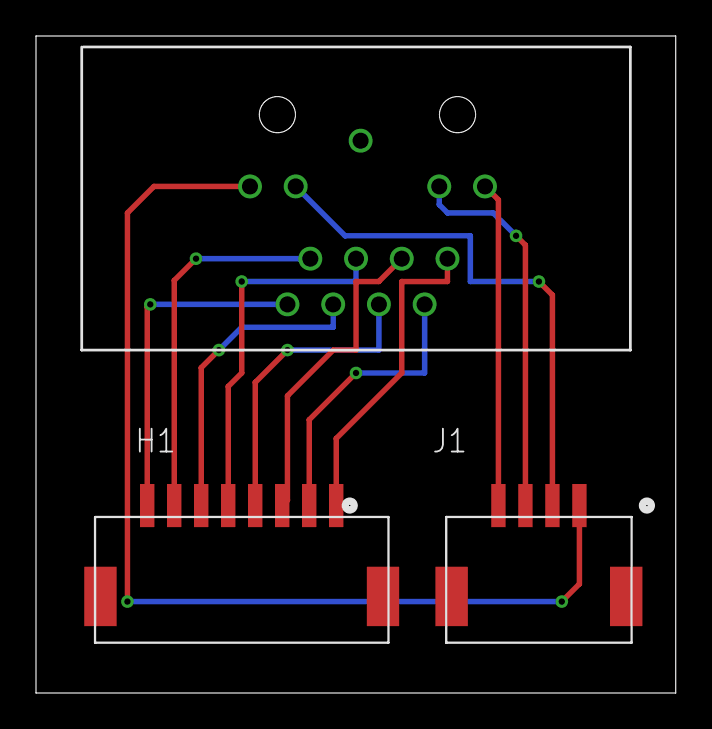
[picture p31: board RJ-45 Dash Daughter Board.brd from above]

Board: 2 copper layers, 35.5 x 36.5 mm, 3 parts (0 on the bottom side), 12 nets.
