MiataMike/FE04-Dash/Right Ear/Right Ear Board.brd

## EAGLE design Right Ear/Right Ear Board.brd (2018-02-11)

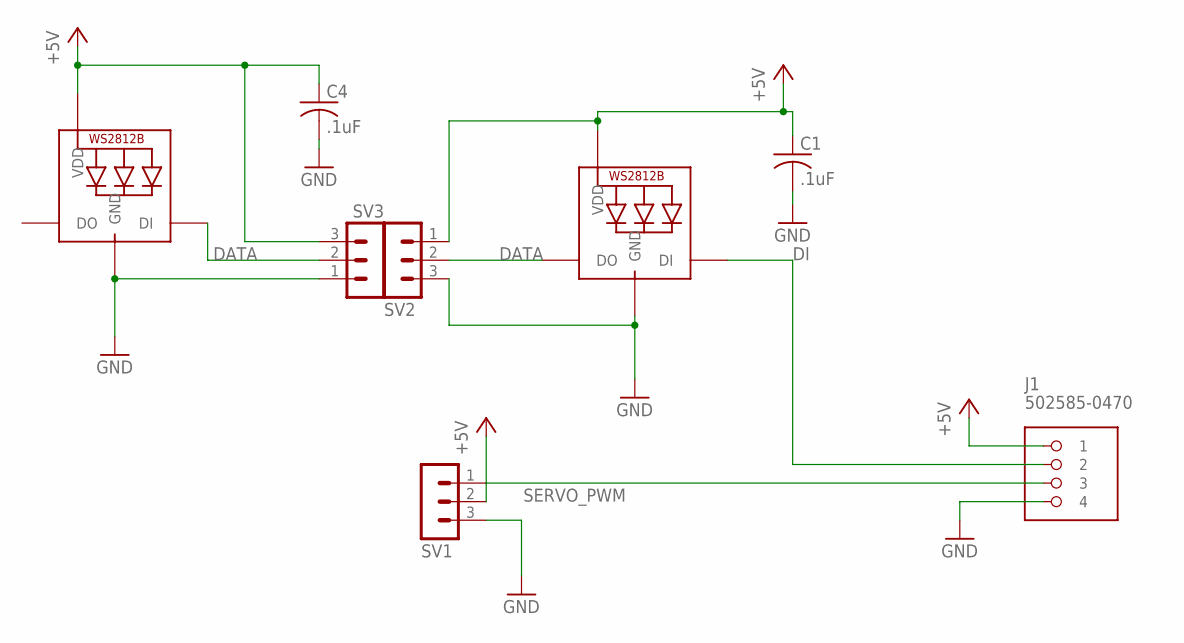
[picture p32: schematic Right Ear Board.sch]

Parts:
C1, C4: .1uF; C0603K; PARTNO GRM188R61A106KE69D
J1: 502585-0470; MOLEX-CLIKMATE-4-R/A
LED1, LED7: WS2812B5050; WS2812B
SV1, SV2, SV3: MA03-1

Connections:
+5V: C1.1, C4.1, J1.1, LED1.1-VDD (VDD), LED7.1-VDD (VDD), SV1.2, SV2.1, SV3.3
DATA: LED1.2-DOUT (DO), LED7.4-DIN (DI), SV2.2, SV3.2
DI: J1.2, LED1.4-DIN (DI)
GND: C1.2, C4.2, J1.4, LED1.3-GND (GND), LED7.3-GND (GND), SV1.3, SV2.3, SV3.1
SERVO_PWM: J1.3, SV1.1

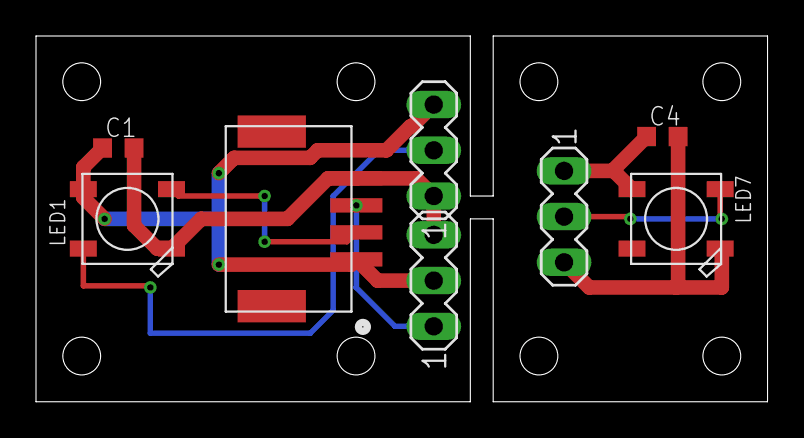
[picture p33: board Right Ear Board.brd from above]

Board: 2 copper layers, 40.6 x 20.3 mm, 8 parts (0 on the bottom side), 5 nets.
