MiataMike/FE04-Dash/Teensy Code/Teensy_Code/screenCode.h

#ifndef SCREENCODE_H
#define SCREENCODE_H

#include <Arduino.h>
#include "variables.h"

void setupScreen();
void startScreen();
void printCommonBackground();
void printUpdates();
void updateScreenSOC();
void updateScreenBatteryTemp();
void updateScreenCarSpeed();
void updateScreenLVVoltage();
void updateScreenMaxTorque();
void printScreenTitle(String title);
void printCommonScreenInfo(String title);
void printBrakeScreen();
void bmpDraw(const char *filename, uint8_t x, uint16_t y);
uint16_t read16(File &f);
uint32_t read32(File &f);


#endif
