MiataMike/FE04-Dash/(commit log)

2017-09-03 Added Teensy, Power Converter, and LED's
    [Initial layout.sch]
2018-01-20 Changed Teensy from 3.1 to 3.5/6
    [Initial layout.brd, Left Ear Board.brd, Left Ear Board.sch]
2018-01-24 Worked on board schematic
    [Left Ear Board.sch]
2018-01-25 Finished Board Schematic. Routing needs to be done.
    [Left Ear Board.brd, Left Ear Board.sch]
2018-01-25 Remove all the backups
    [Initial layout.brd, Initial layout.sch]
2018-01-25 Finished board layout
    [Left Ear Board.brd, Left Ear Board.sch]
2018-01-25 Worked on schematic. Connected some wires
    [Initial layout.brd, Initial layout.sch]
2018-01-26 Added some connectors.
    [Initial layout.brd, Initial layout.sch]
2018-01-26 Gave Mike an Analog Line
    [Initial layout.brd, Initial layout.sch]
2018-01-26 Worked on connecor pin
    [Initial layout.brd, Initial layout.sch]
2018-01-26 Finished Schematic?? Probably.
    [Initial layout.brd, Initial layout.sch]
2018-01-26 Rough board work
    [Initial layout.brd, Initial layout.sch]
2018-01-27 Finished Schematic
    [Initial layout.brd, Initial layout.sch]
2018-01-27 Begin Board layout
    [Initial layout.brd]
2018-01-27 Needs to be looked over and modeled in solidworks
    [USB Dash Daughter Board.brd, USB Dash Daughter Board.sch]
2018-01-27 Added 4 pin clickmate for rj45
    [Initial layout.brd, Initial layout.sch]
2018-01-27 Added resistors for LEDs
    [Initial layout.brd, Initial layout.sch]
2018-01-27 Created RJ-45 Device, and RJ-45 Dash Daughter Board
    [RJ-45 Dash Daughter Board.brd, RJ-45 Dash Daughter Board.sch]
2018-01-27 Created Right Ear Board and made adjustments to Dash
    [Initial layout.brd, Initial layout.sch, Right Ear Board.sch]
2018-01-28 Made a folder for Teensy Code and downloaded libraries
2018-01-28 Defined Pins, Updated names on schematic
    [Initial layout.brd, Initial layout.sch]
2018-02-07 Updated board layout
    [Initial layout.brd]
2018-02-08 Updated schematic and board layout
    [Initial layout.brd, Initial layout.sch]
2018-02-08 Add in teensy libraries
2018-02-08 Add a note for how to get teensy libraries
2018-02-08 Finish board layout for main dash
    [Initial layout.brd, Initial layout.sch]
2018-02-09 Updated Schematic
    *Warning* The board did not update with the schematic
    [Initial layout.sch]
2018-02-09 Brandon did a thing
    [Right Ear Board.brd, Right Ear Board.sch]
2018-02-09 Fixed Ashers fuck up
    [Center Dash.brd, Center Dash.sch, Left Ear Board.brd, Left Ear Board.sch, RJ-45 Dash Daughter Board.brd, RJ-45 Dash Daughter Board.sch, Right Ear Board.brd, Right Ear Board.sch]
2018-02-10 Update right ear boards
    [Right Ear Board.brd, Right Ear Board.sch]
2018-02-10 Made changes
    Change LED caps to .1uF on right ear and center
    Add resistor to D2
    Add level shifters (1 for D1, 1 for D2)
    Add mount holes on right ear
    [Center Dash.brd, Center Dash.sch, Left Ear Board.sch, Right Ear Board.brd, Right Ear Board.sch]
2018-02-10 Made changes
    Add mosfet for servo (see things to consider.txt)
    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
    [Center Dash.brd, Center Dash.sch, Left Ear Board.sch, Right Ear Board.brd, Right Ear Board.sch]
2018-02-10 Redid right ear board layouts
    [Center Dash.brd, Right Ear Board.brd]
2018-02-11 Added level shifter to center dash
    [Center Dash.brd, Center Dash.sch, Right Ear Board.brd]
2018-02-11 Done with board layouts
    [Center Dash.brd, Center Dash.sch, RJ-45 Dash Daughter Board.brd, Right Ear Board.brd, Right Ear Board.sch]
2018-02-13 Worked on code
    Updated board layouts since shit changed
    [Center Dash.brd, Center Dash.sch, Left Ear Board.brd, Left Ear Board.sch]
2018-02-28 Fix for daqbus CAN
    Added another can transceiver for the daq bus
    Moved the ignition1 and 2 to different pins to account for the teensy can bus lines
    Fixed the can code from flexcan
    [Center Dash.brd, Center Dash.sch]
2018-02-28 Had to change a name from CARCAN to DAQCAN
    [Center Dash.brd]
2018-02-28 Add voltage dividers to 5V input lines
    Now we can use Teensy 3.6
    [Center Dash.brd, Center Dash.sch]
2018-03-01 last minute fix again
    [Center Dash.brd, Center Dash.sch]
2018-03-20 Fixed?? amp seal connector
    [Center Dash.brd, Center Dash.sch]
2018-03-20 Rotate LEDs. Might fit better??
    [Center Dash.brd]
2018-03-20 Fix silk screens
    [Center Dash.brd]
2018-03-22 Update schematic to remove last spare
    [Center Dash.brd, Center Dash.sch]
2018-03-23 Made the servo do a thing
2018-03-24 I dont remember
    [Center Dash.brd, Center Dash.sch]
2018-03-24 Added Neopixel Color guide and Servo needle
    [Servo Needle.DXF, Servo Needle.SLDPRT]
2018-03-24 Updated Neopixel Battery Color Guide
2018-03-25 CAN works now
    [Servo Needle.DXF, Servo Needle.SLDPRT]
2018-03-25 Put dash part files and stickers in
    [Left Ear Master v2.SLDPRT, Left Ear Master v2.STL, Right Ear (BEST).SLDPRT, Right Ear (BEST).STL]
2018-03-25 I fucking hate wires. They are stupid and antennas are gay
2018-04-06 Added Steering Wheel Enclosure and Board
    Enclosure still needs RJ-45 jack and board taken into account. Board needs to be laid out.
    [Paddle Enclosure.SLDPRT, Steering Wheel Board.brd, Steering Wheel Board.sch, Switch.SLDPRT, button.SLDPRT, steering_wheel.SLDPRT, wheel assembly.SLDASM]
2018-04-06 Someone flipped the ignition wires
    [Teensy_Code.ino]
2018-05-03 Fix drive Mode can message of destiny
    [Teensy_Code.ino]
2018-05-04 Fix dash temp lights
    [Teensy_Code.ino, variables.cpp, variables.h]
2018-05-11 Add brake position
2018-05-11 Add special brake message for starting
2018-05-11 Add more brake message logic
2018-05-23 Fixes for regen
    [Knob.SLDPRT, Knob.STL, Needle.SLDPRT, Paddle Enclosure V2.SLDPRT, Paddle Enclosure V3.SLDPRT, Paddle Enclosure V3.STL, Paddle Enclosure V4.SLDPRT, Paddle Enclosure V4.STL]
2018-05-23 Cooling Board stuff
2019-03-14 Fixed some logic errors
    I was dumb when I removed the unnecessary drive modes.
    [Teensy_Code.ino]
2019-03-16 Fixed small compilation errors.
    [Teensy_Code.ino]
2019-05-04 Started fixing this awful code
    [Teensy_Code.ino, screenCode.cpp, screenCode.h, variables.cpp, variables.h]
2020-02-29 Fixing screen bugs
    fix fix fix fix
    added color scaling for SOC
    changed where borders are
    made things centered and prettyyy
    moved current drive mode to bottom
    when in cal mode you KNOW IT
    [Teensy_Code.ino, screenCode.cpp, variables.h]
2020-02-29 Revert "Fixing screen bugs"
    This reverts commit 6ac06dbf13a5eba1d1bc4c3b82cb937deedb7274.
    [Teensy_Code.ino, screenCode.cpp, variables.h]
2020-02-29 updates & bug fixes
    fixing bugs
    [Teensy_Code.ino, screenCode.cpp]
2021-10-13 Fixed Ignition 2
    [Center Dash.brd, Center Dash.sch]
2021-10-16 Fixed two of the via overlaps
    [Center Dash.brd, Center Dash.sch]
2022-04-25 Create Teensy code compliation.pptx
    I had to clean install teensyduino on my laptop so I followed these instructions and was able to compile for t3.6
